JanObrovnik/Mehatronika/README.md

V tem repozitoriju so navedeni primeri kod v povezavi z našim izdelkom razvojne ploščice ESP32­-C3.
