JanObrovnik/Mehatronika/KiCad/README

Tukaj je celoten izdelek (vezje in ploščica) v KiCad-u..
