JanObrovnik/Mehatronika/KiCad/Projekt.kicad_pcb

## KiCad design KiCad/Projekt.kicad_pcb (2024-05-14)

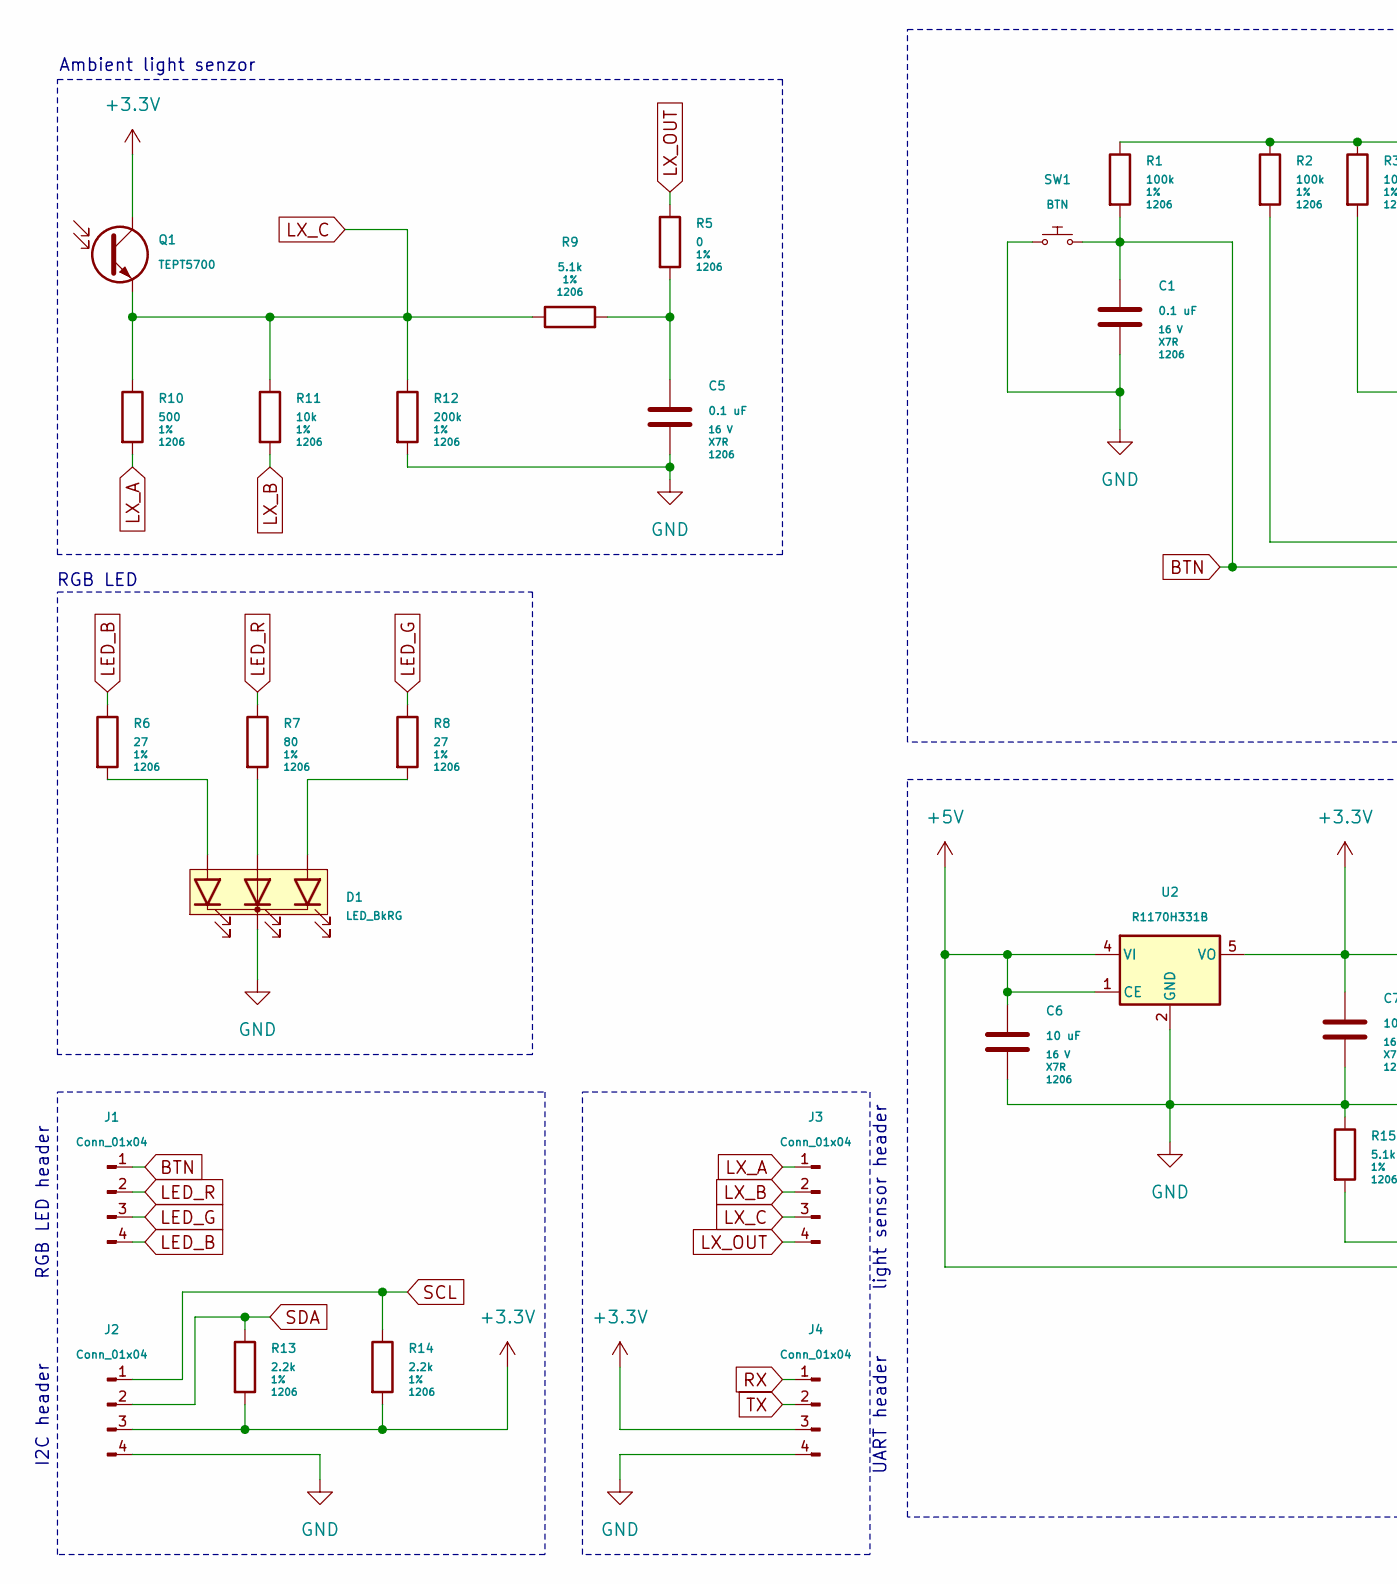
[picture p1: schematic Projekt.kicad_sch, AMETHIST, part in row 1, column 1]

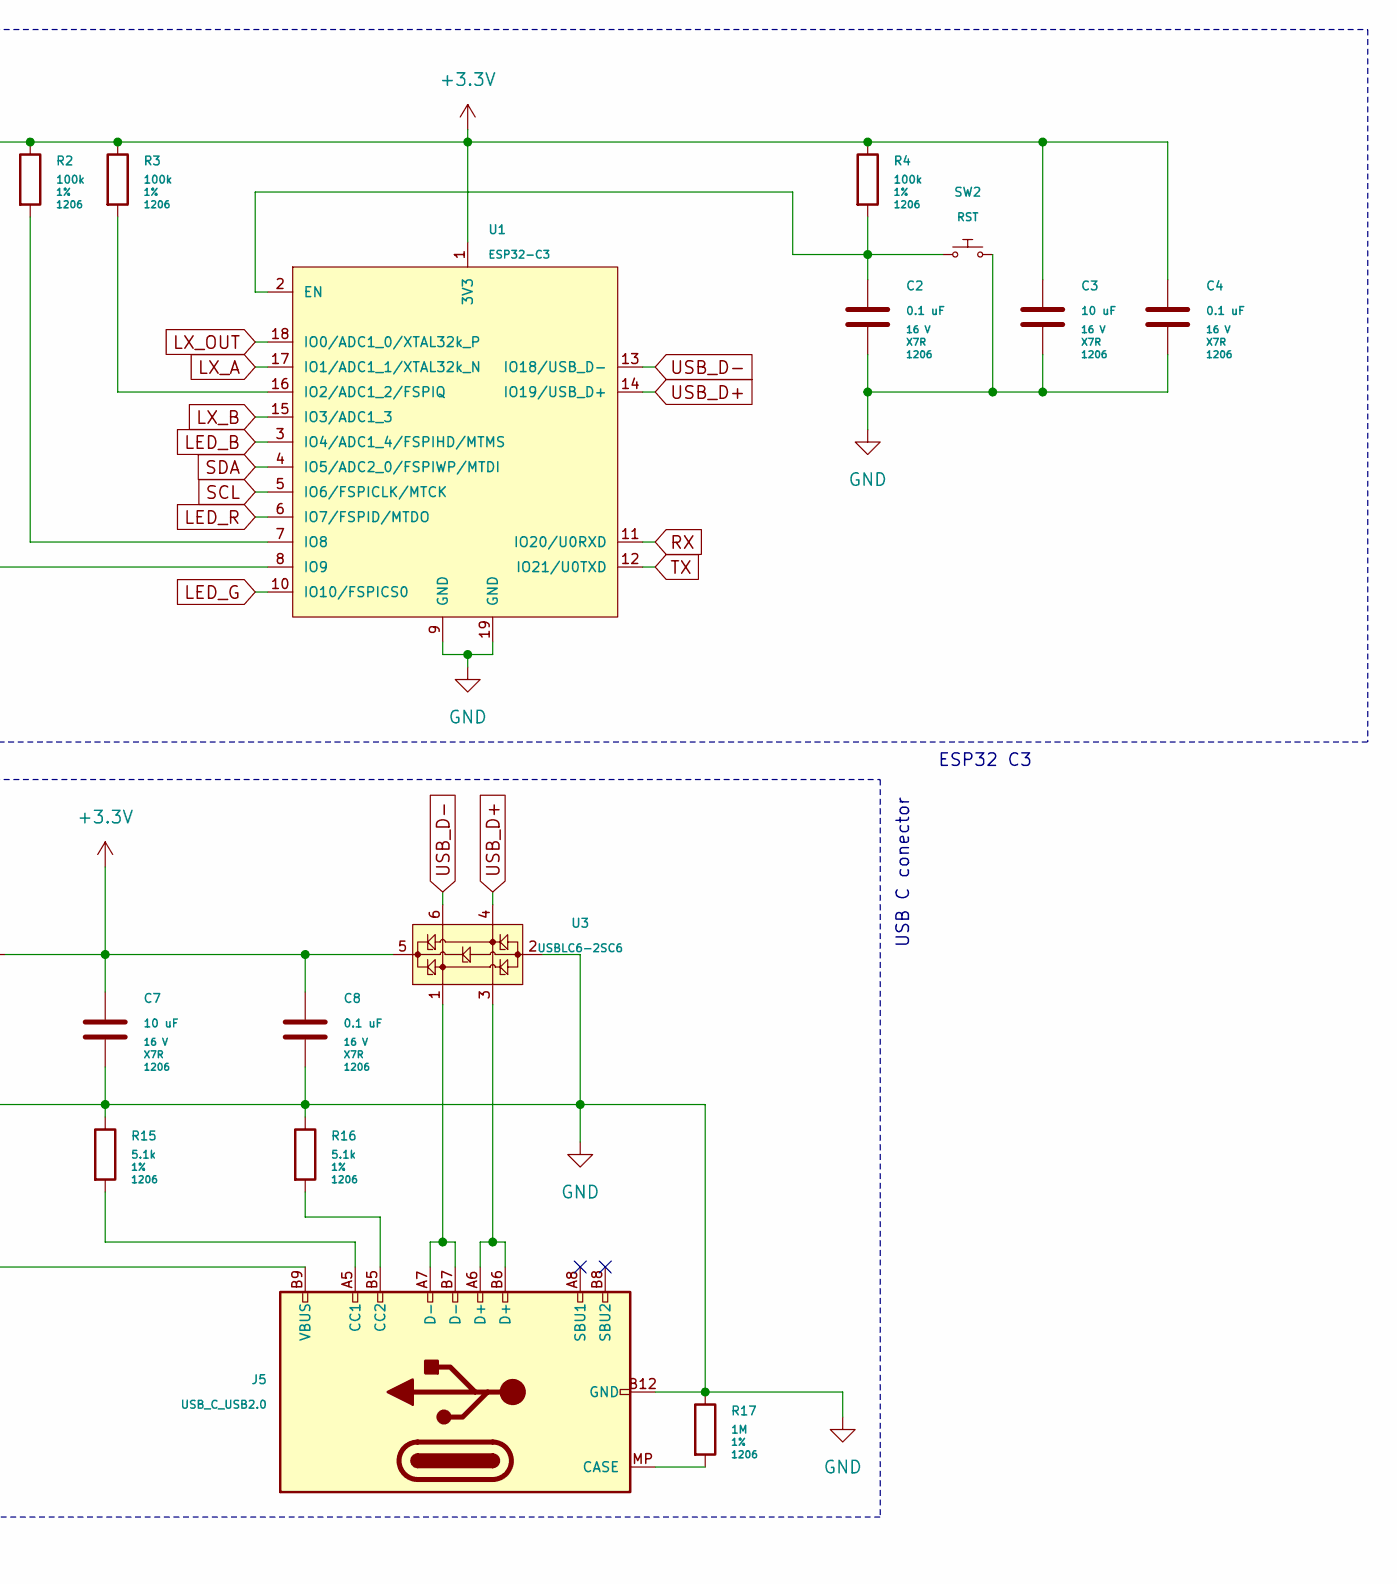
[picture p2: schematic Projekt.kicad_sch, AMETHIST, part in row 1, column 2]

Parts:
C1, C2, C4, C5, C8: 0.1 uF; C_1206_(3216); Voltage 16 V; Tolerance X7R
C3, C6, C7: 10 uF; C_1206_(3216); Voltage 16 V; Tolerance X7R
D1: LED_BkRG; LED_D5.0mm-4_RGB
J1, J2, J3, J4: Conn_01x04; PinHeader_1x04_P2.54mm_Vertical
J5: USB_C_USB2.0; USB-C_MOLEX-216990-0001
Q1: TEPT5700; PT_D5.0mm
R1, R2, R3, R4: 100k; R_1206_(3216); Tolerance 1%
R5: 0; R_1206_(3216); Tolerance 1%
R6, R8: 27; R_1206_(3216); Tolerance 1%
R7: 80; R_1206_(3216); Tolerance 1%
R9, R15, R16: 5.1k; R_1206_(3216); Tolerance 1%
R10: 500; R_1206_(3216); Tolerance 1%
R11: 10k; R_1206_(3216); Tolerance 1%
R12: 200k; R_1206_(3216); Tolerance 1%
R13, R14: 2.2k; R_1206_(3216); Tolerance 1%
R17: 1M; R_1206_(3216); Tolerance 1%
SW1: BTN; SW_PUSH_6mm_SMD
SW2: RST; SW_PUSH_6mm_SMD
U1: ESP32-C3; ESP32-C3-WROOM-02
U2: R1170H331B; SOT-89-5
U3: USBLC6-2SC6; SOT-23-6

Connections:
+3.3V: C3.1, C4.1, C7.1, C8.1, J2.3, J4.3, Q1.C, R1.1, R2.1, R3.1, R4.1, R13.2, R14.2, U1.1 (3V3), U2.5 (VO), U3.5 (VBUS)
+5V: C6.1, J5.A4 (VBUS), J5.A9 (VBUS), J5.B4 (VBUS), J5.B9 (VBUS), U2.1 (CE), U2.4 (VI)
BTN: C1.1, J1.1, R1.2, SW1.COM, U1.8 (IO9); also elsewhere on the board
GND: C1.2, C2.2, C3.2, C4.2, C5.2, C6.2, C7.2, C8.2, D1.K, J2.4, J4.4, J5.A1 (GND), J5.A12 (GND), J5.B1 (GND), J5.B12 (GND), R12.2, R15.1, R16.1, R17.1, SW1.NO, SW2.COM, U1.9 (GND), U1.19 (GND), U2.2 (GND), U3.2 (GND); also elsewhere on the board
LED_B: J1.4, R6.1, U1.3 (IO4/ADC1_4/FSPIHD/MTMS)
LED_G: J1.3, R8.1, U1.10 (IO10/FSPICS0)
LED_R: J1.2, R7.1, U1.6 (IO7/FSPID/MTDO)
LX_A: J3.1, R10.2, U1.17 (IO1/ADC1_1/XTAL32k_N)
LX_B: J3.2, R11.2, U1.15 (IO3/ADC1_3)
LX_C: J3.3, Q1.E, R9.1, R10.1, R11.1, R12.1
LX_OUT: J3.4, R5.1, U1.18 (IO0/ADC1_0/XTAL32k_P)
unnamed: C5.1, R5.2, R9.2
unnamed: D1.Ab (Ablue), R6.2
unnamed: D1.Ag (Agreen), R8.2
unnamed: D1.Ar (Ared), R7.2
unnamed: J5.MP (CASE), R17.2
unnamed: J5.A5 (CC1), R15.2
unnamed: J5.B5 (CC2), R16.2
unnamed: J5.A6 (D+), J5.B6 (D+), U3.3 (I/O2)
unnamed: J5.A7 (D-), J5.B7 (D-), U3.1 (I/O1)
unnamed 20: C2.1, R4.2, SW2.NO, U1.2 (EN); also elsewhere on the board
unnamed: R3.2, U1.16 (IO2/ADC1_2/FSPIQ)
unnamed: R2.2, U1.7 (IO8)
RX: J4.1, U1.11 (IO20/U0RXD)
SCL: J2.1, R14.1, U1.5 (IO6/FSPICLK/MTCK)
SDA: J2.2, R13.1, U1.4 (IO5/ADC2_0/FSPIWP/MTDI)
TX: J4.2, U1.12 (IO21/U0TXD)
USB_D+: U1.14 (IO19/USB_D+), U3.4 (I/O2)
USB_D-: U1.13 (IO18/USB_D-), U3.6 (I/O1)

Notes on the sheet:
ESP32 C3
RGB LED header
UART header
I2C header
RGB LED
Ambient light senzor
light sensor header
USB C conector

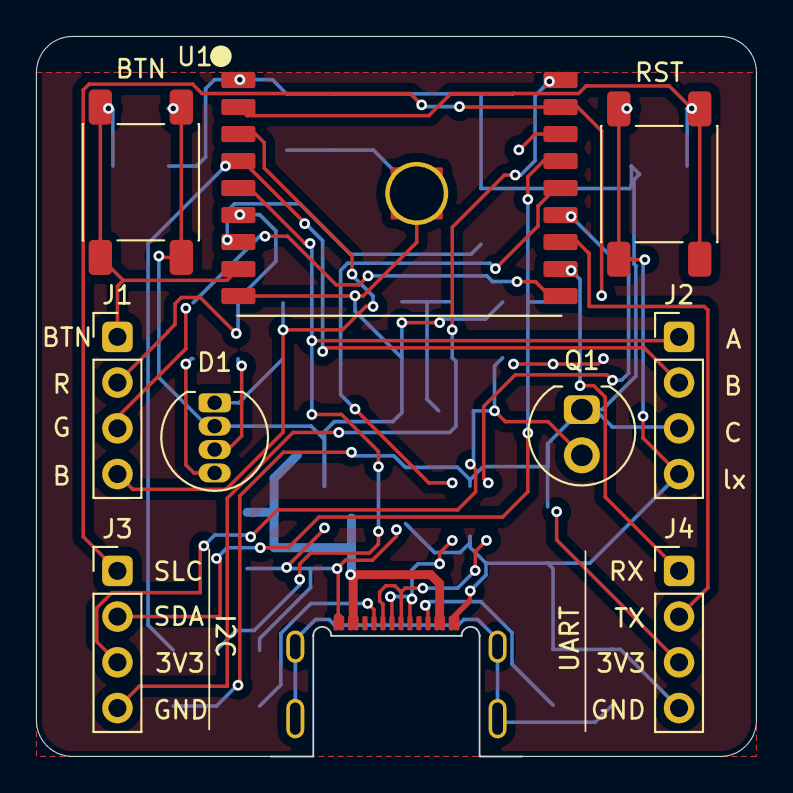
[picture p3: board Projekt.kicad_pcb from above]

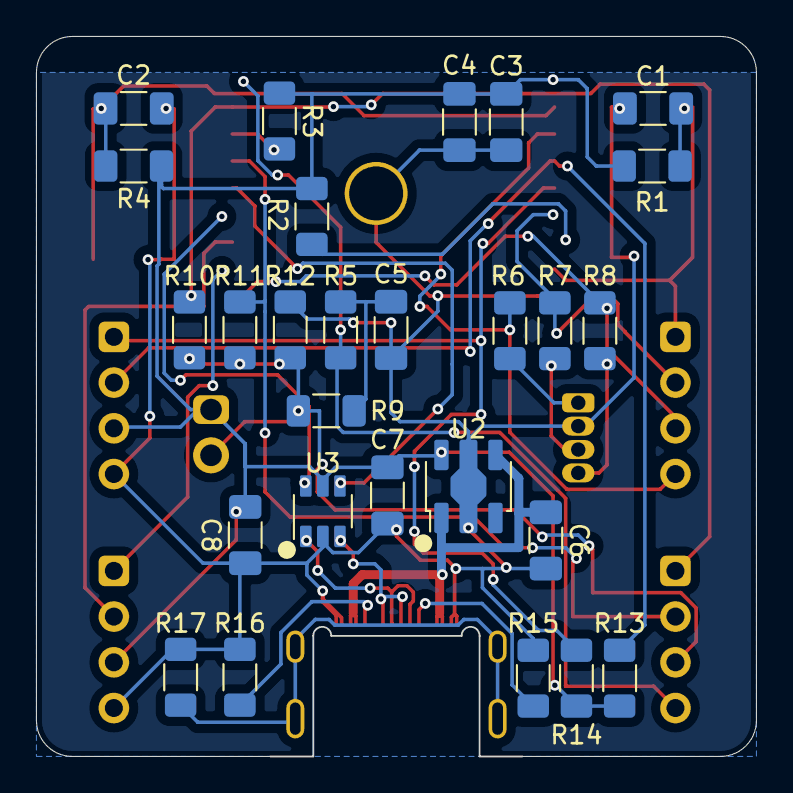
[picture p4: board Projekt.kicad_pcb from below]

Board: 2 copper layers, 40.0 x 40.0 mm, 37 parts (27 on the bottom side), 29 nets.

Other parts of the board:
BTN: BTN; SW_PUSH_6mm_SMD
RST: RST; SW_PUSH_6mm_SMD

Their connections:
BTN: BTN.COM; also elsewhere on the board
GND: BTN.NO, RST.COM; also elsewhere on the board
unnamed 20: RST.NO; also elsewhere on the board
