JanObrovnik/Mehatronika/(commit log)

2024-05-12 Naložitev primera uporabe UART
2024-05-14 KiCad projekt
    [Projekt.kicad_pcb, Projekt.kicad_sch]
2024-05-20 Popravek sheme board
